Krit8025/Baja-ATV-Steering-Knuckle/FrontKnuckle.SLDPRT

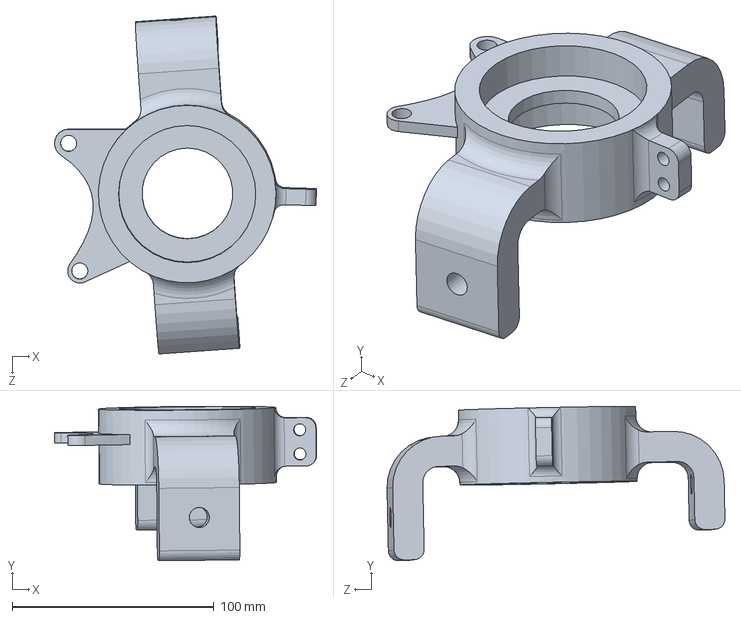
[picture p6: CAD file, 2026-10-27]
FrontKnuckle.SLDPRT
129.9 x 76.6 x 167.5 mm
